dmarion/modbus-flow-meter/pcb/pcb_bottom_v2.pdf

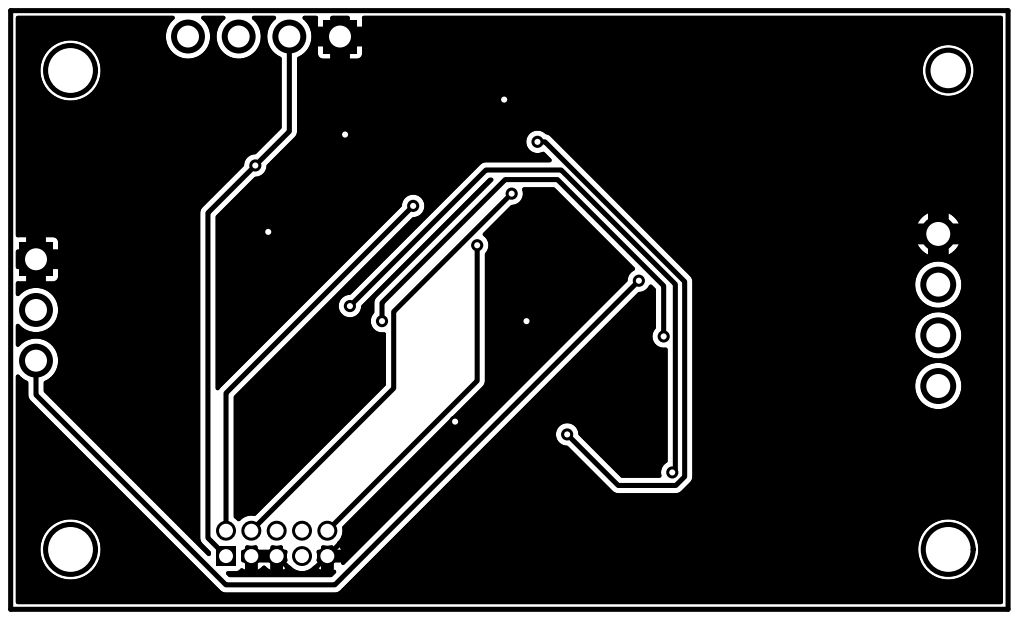
[picture p1: page 1]
