dmarion/modbus-flow-meter/pcb/pcb_top_v2.pdf

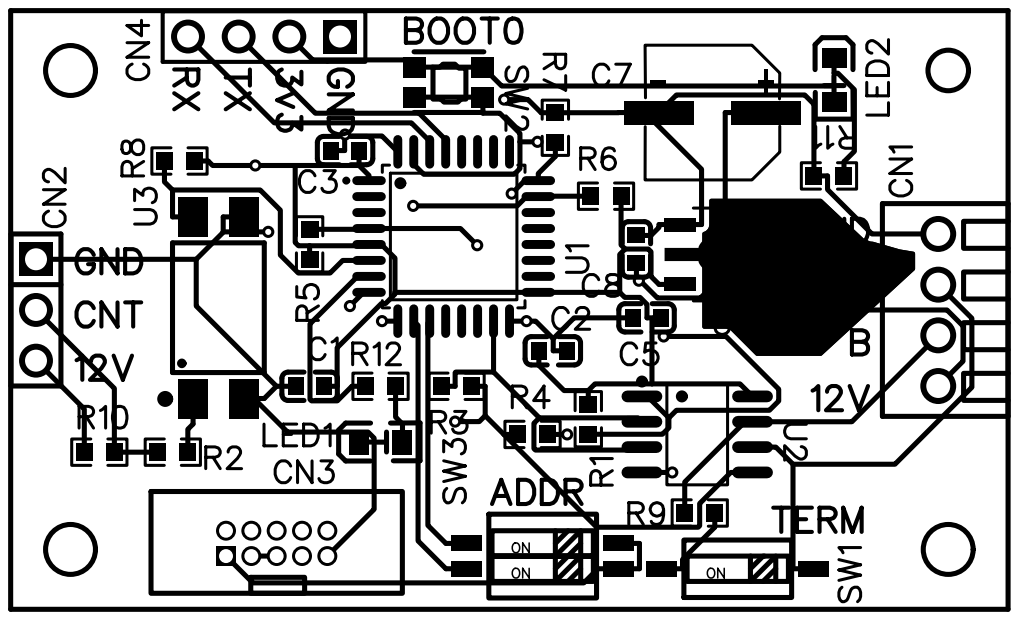
[picture p2: page 1]
