dmarion/modbus-flow-meter/pcb/sch_v2.pdf

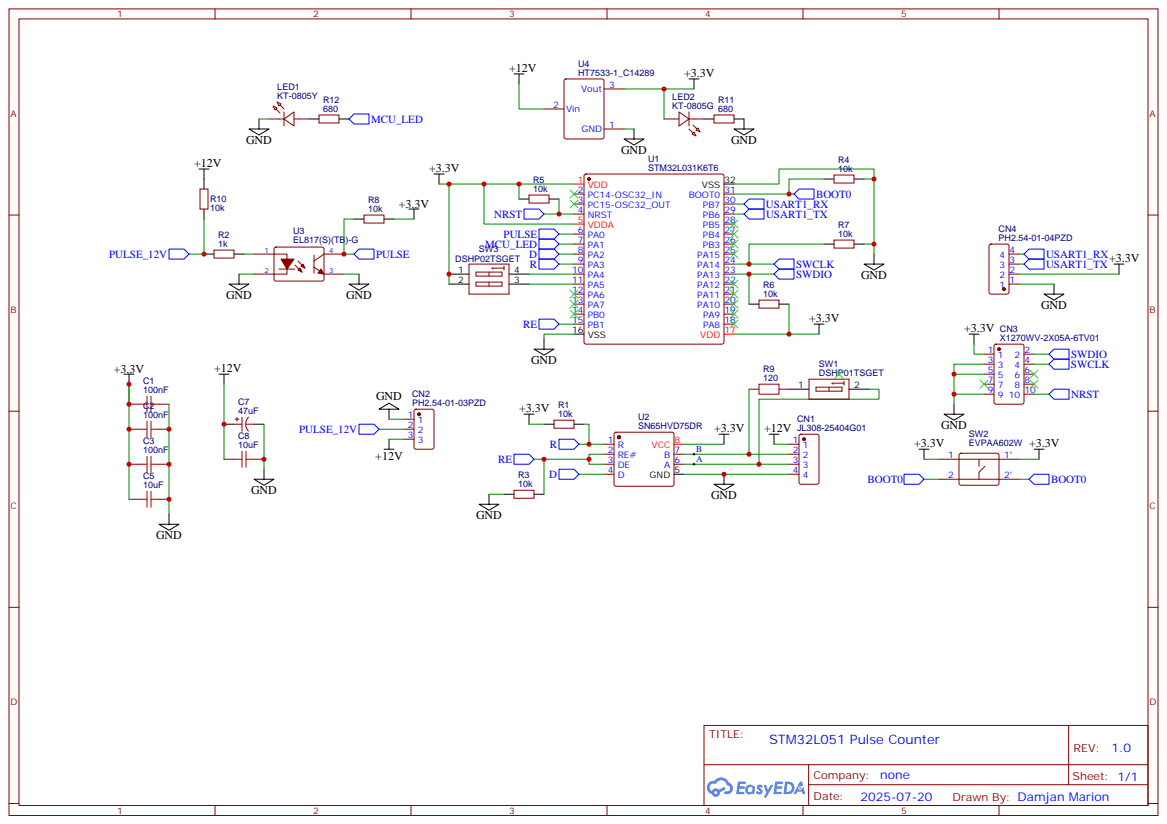
[picture p3: page 1]

Drawn By: Damjan Marion
