dmarion/modbus-flow-meter/(list of files, drawings)

Other design files:
pcb/pcb_counter_easyeda_v2.json
pcb/sch_counter_easyeda_v2.json
